LivioScherrer/MinTurtle/hardware/docs/pcb-bottom.png

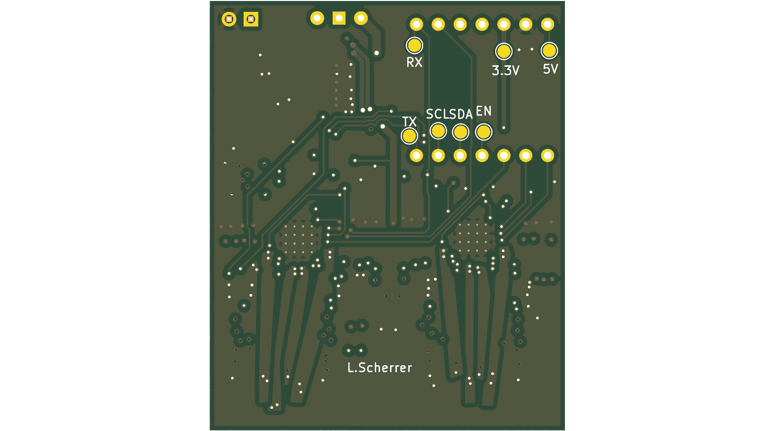
hardware/docs/pcb-bottom.png
