LivioScherrer/MinTurtle/hardware/docs/pcb-top.png

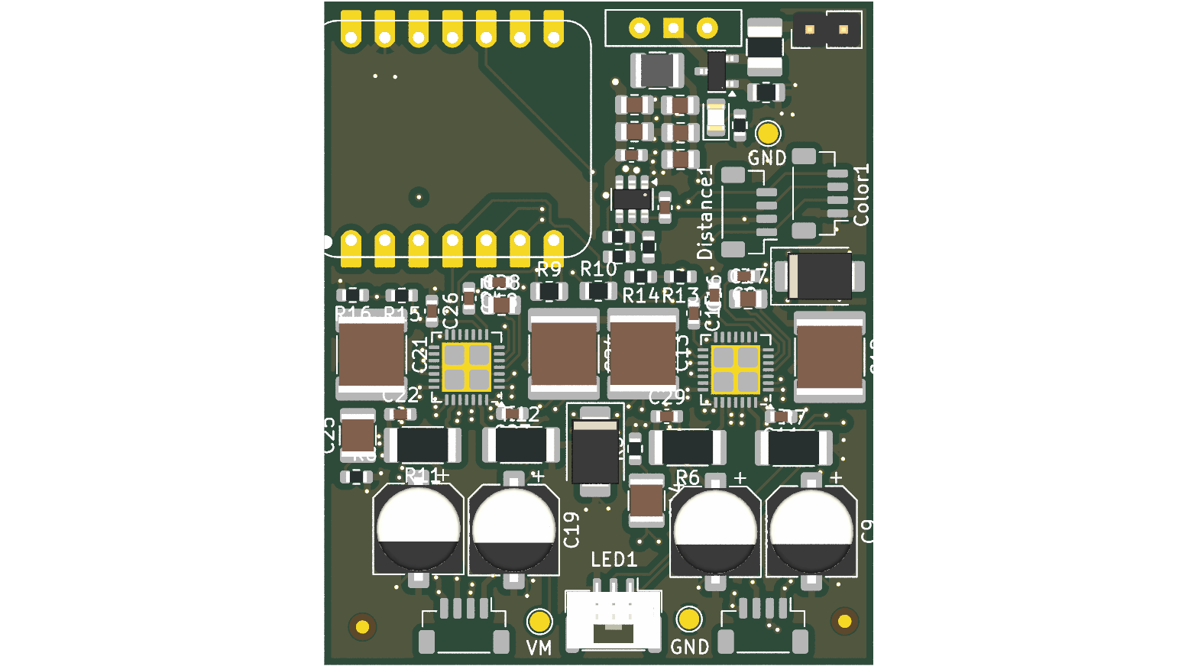
hardware/docs/pcb-top.png
