LivioScherrer/MinTurtle/hardware/3d-models/PCB_Halter.step

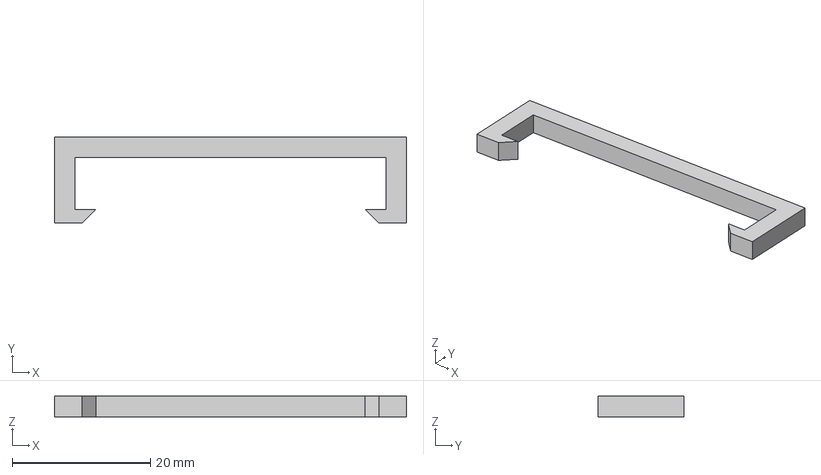
[picture p3: CAD file, 2026-10-19]
hardware/3d-models/PCB_Halter.step
51.0 x 12.5 x 3.00 mm
