LivioScherrer/MinTurtle/hardware/3d-models/ErhöhungV2.step

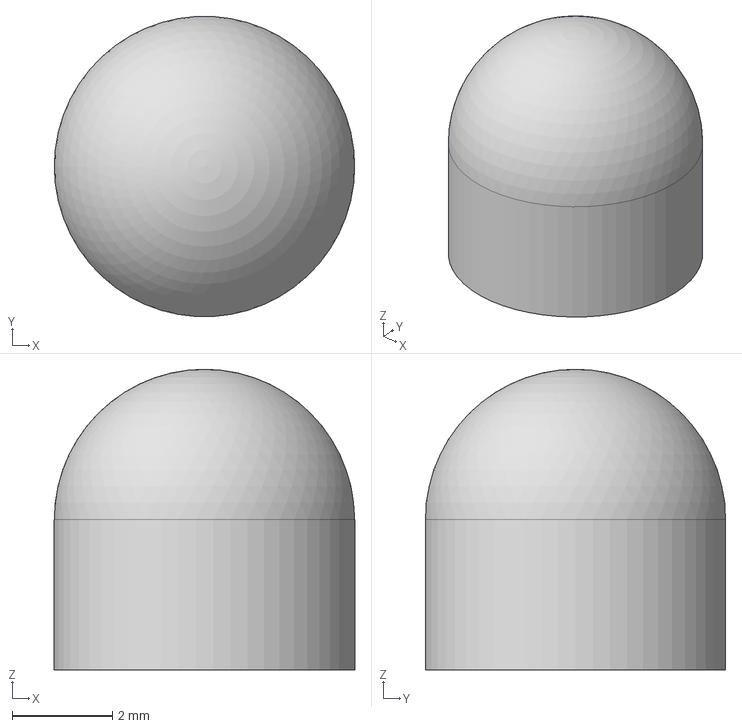
[picture p4: CAD file, 2026-10-19]
hardware/3d-models/ErhöhungV2.step
6.00 x 5.99 x 6.00 mm
