LivioScherrer/MinTurtle/hardware/3d-models/EduV2_Chassis.step

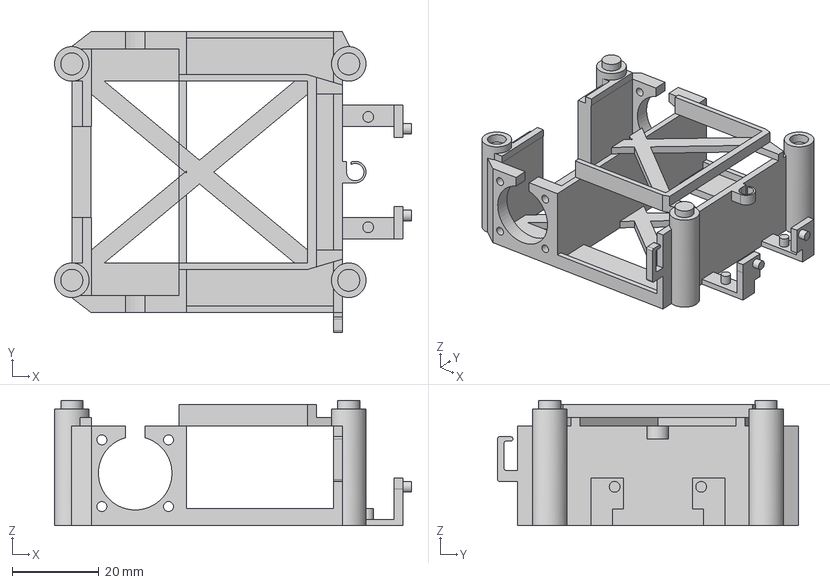
[picture p5: CAD file, 2026-10-19]
hardware/3d-models/EduV2_Chassis.step
82.5 x 69.6 x 29.0 mm
