LivioScherrer/MinTurtle/hardware/3d-models/RAD.step

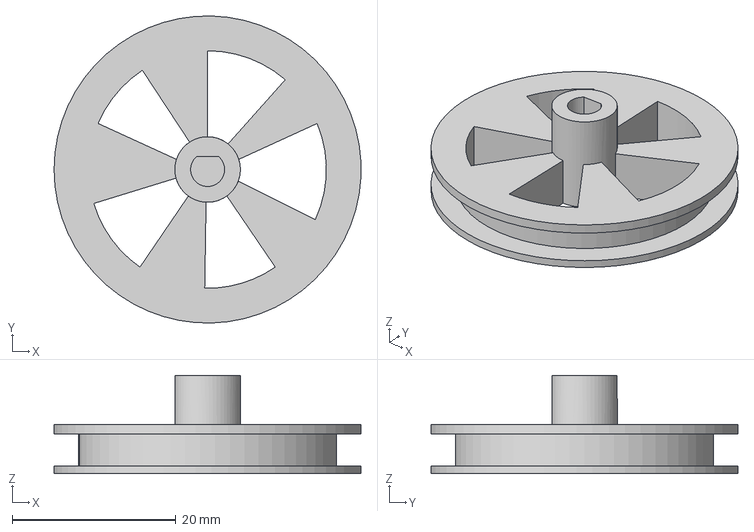
[picture p6: CAD file, 2026-10-19]
hardware/3d-models/RAD.step
37.5 x 37.5 x 12.0 mm
