LivioScherrer/MinTurtle/hardware/docs/schematic.pdf

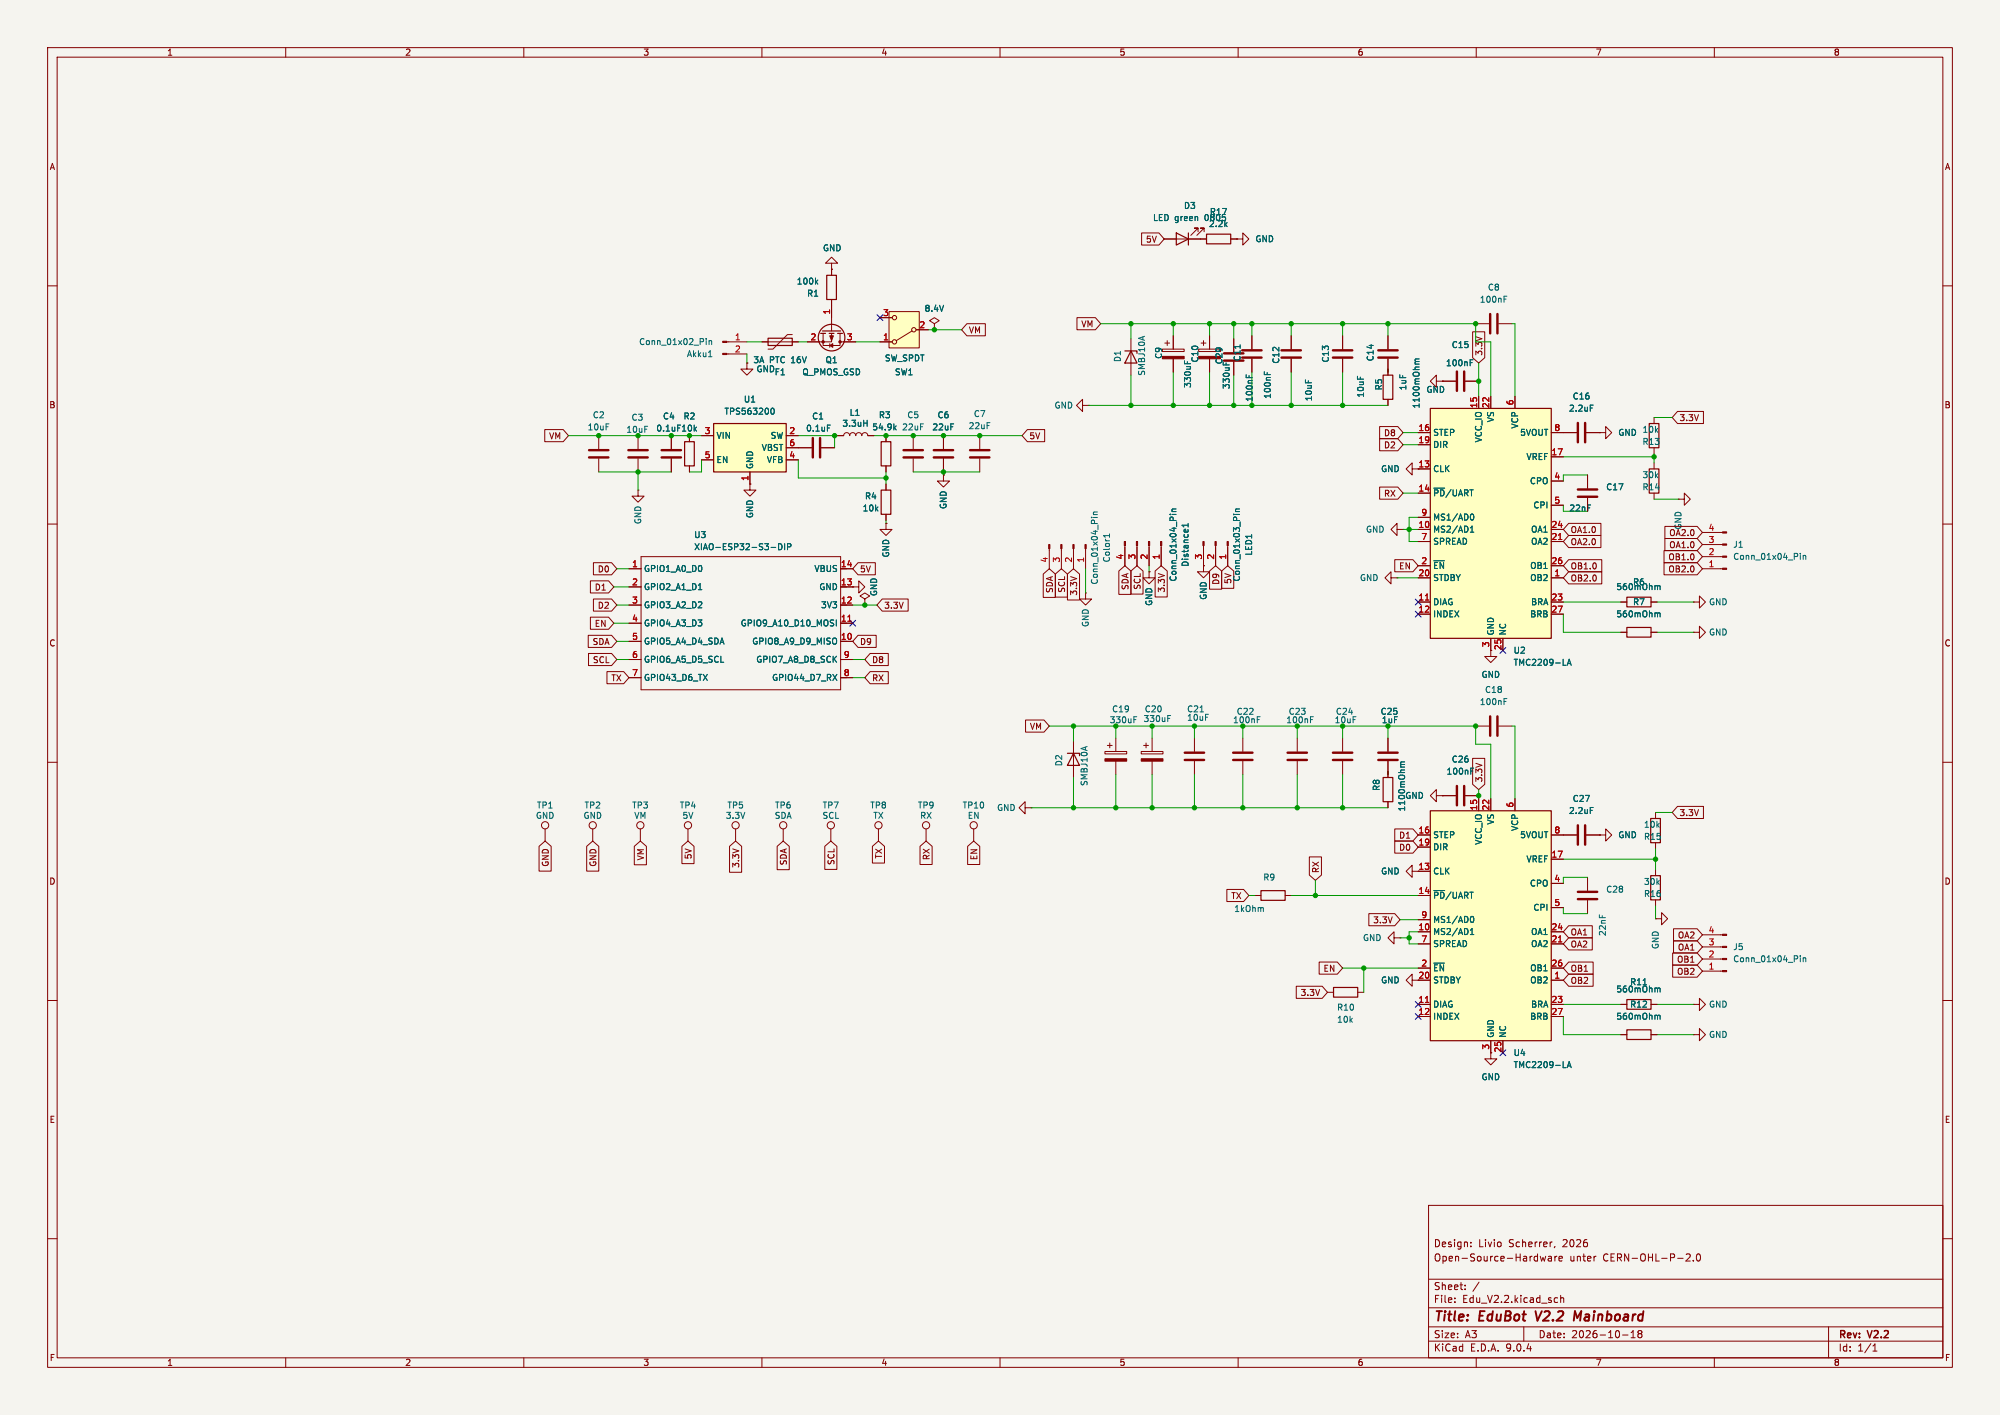
[picture p7: page 1]

560mOhm
STEP 16 DIR 19 CLK 13 ~{PD}/UART 14 MS1/AD0 9 MS2/AD1 10 SPREAD 7 ~{EN} 2 STDBY 20 DIAG 11

5VOUT 8 VREF 17 CPO 4 CPI 5 OA1 24 OA2 21 OB1 26 OB2 1 BRA 23 BRB 27 U4 TMC2209-LA

5VOUT 8 VREF 17 CPO 4 CPI 5 OA1 24 OA2 21 OB1 26 OB2 1 BRA 23 BRB 27 GND

Id: 1/1 Title: EduBot V2.2 Mainboard
