LivioScherrer/MinTurtle/hardware/Edu_V2.2.kicad_pcb

## KiCad design hardware/Edu_V2.2.kicad_pcb (2026-10-18)

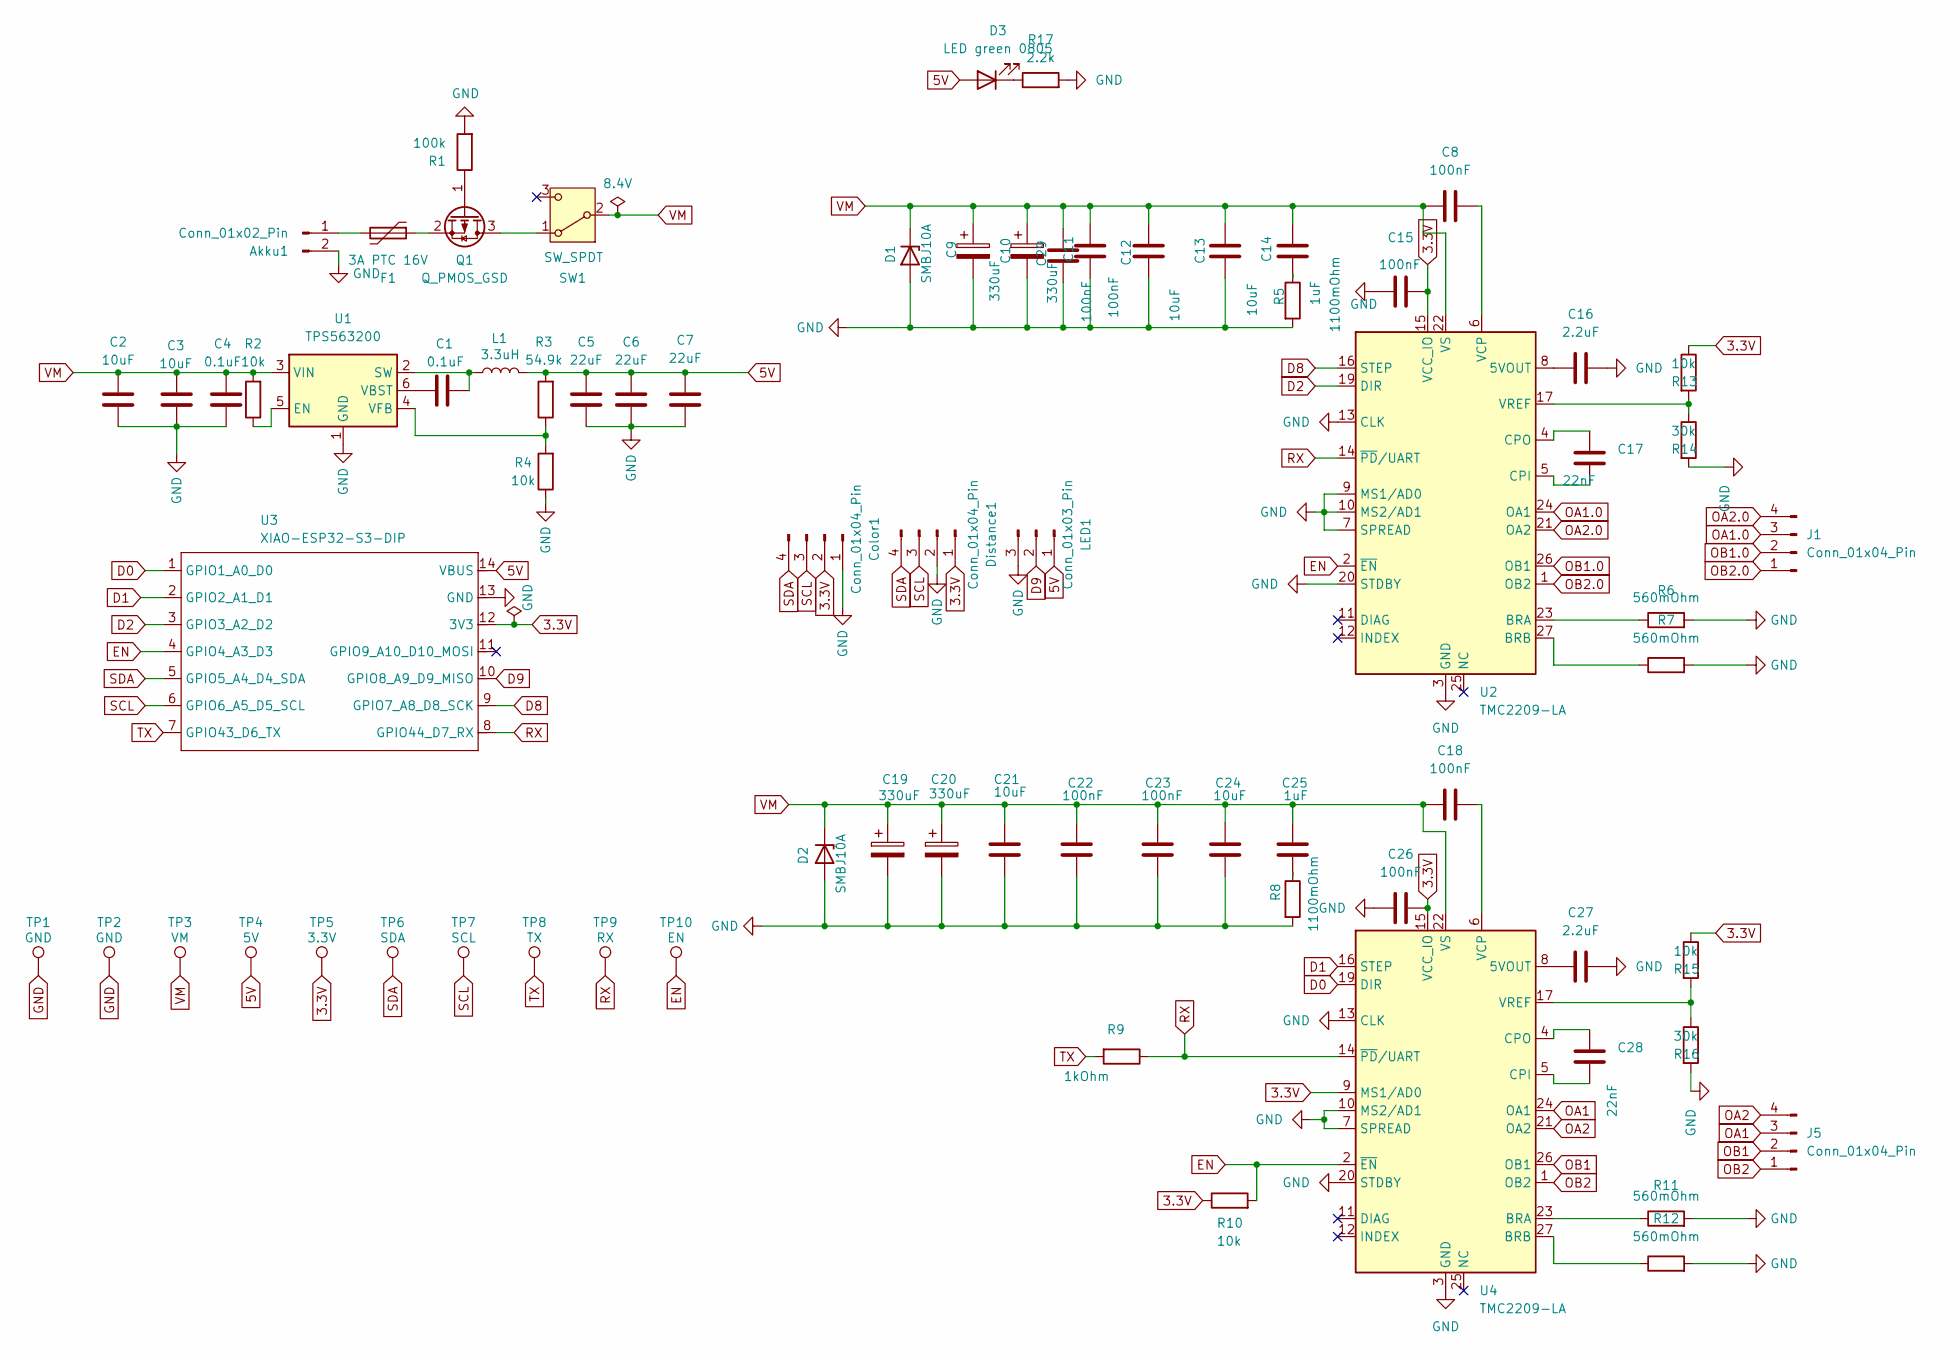
[picture p8: schematic Edu_V2.2.kicad_sch, EduBot V2.2 Mainboard]

Parts:
Akku1: Conn_01x02_Pin; PinHeader_1x02_P2.54mm_Vertical; MPN PZ254V-11-02P
C1, C4: 0.1uF; C_0603_1608Metric; MPN CC0603KRX7R9BB104; LCSC C14663
C2, C3: 10uF; C_0805_2012Metric; MPN CL21A106KAYNNNE; LCSC C15850
C5, C6, C7: 22uF; C_0805_2012Metric; MPN CL21A226MAQNNNE; LCSC C45783
C8, C11, C15, C18, C22, C23, C26, C29: 100nF; C_0603_1608Metric; MPN CC0603KRX7R9BB104; LCSC C14663
C9, C10, C19, C20: 330uF; CP_Elec_6.3x7.7; MPN GVM1E331M0607; LCSC C2980171
C12, C13, C21, C24: 10uF; C_2220_5750Metric; MPN FS55X106K500EGG; LCSC C153034
C14, C25: 1uF; C_1210_3225Metric; MPN CL32B105KBHNNNE; LCSC C40708
C16, C27: 2.2uF; C_0603_1608Metric; MPN CC0603KRX5R8BB225; LCSC C309478
C17, C28: 22nF; C_0805_2012Metric; MPN CL21B223KBANNNC; LCSC C1729
Color1: Conn_01x04_Pin; JST_SH_BM04B-SRSS-TB_1x04-1MP_P1.00mm_Vertical; MPN BM04B-SRSS-TB(LF)(SN); LCSC C160390
D1, D2: SMBJ10A; D_SMB; MPN SMBJ10A; LCSC C353406
D3: LED green 0805; LED_0805_2012Metric; MPN KT-0805G; LCSC C2297
Distance1: Conn_01x04_Pin; JST_SH_BM04B-SRSS-TB_1x04-1MP_P1.00mm_Vertical; MPN BM04B-SRSS-TB(LF)(SN); LCSC C160390
F1: 3A PTC 16V; Fuse_1210_3225Metric_Pad1.42x2.65mm_HandSolder; MPN 1210L300/16WR; LCSC C22379948
J1, J5: Conn_01x04_Pin; JST_SH_BM04B-SRSS-TB_1x04-1MP_P1.00mm_Vertical; MPN BM04B-SRSS-TB(LF)(SN); LCSC C160390
L1: 3.3uH; L_1210_3225Metric; MPN DFE322512F-3R3M=P2; LCSC C3221010
LED1: Conn_01x03_Pin; JST_GH_BM03B-GHS-TBT_1x03-1MP_P1.25mm_Vertical; MPN BM03B-GHS-TBT(LF)(SN); LCSC C161691
Q1: Q_PMOS_GSD; SOT-23; MPN AO3401A; LCSC C15127
R1: 100k; R_0805_2012Metric; MPN 0805W8F1003T5E; LCSC C149504
R2, R4, R13, R15: 10k; R_0603_1608Metric; MPN 0603WAF1002T5E; LCSC C25804
R3: 54.9k; R_0603_1608Metric; MPN 0603WAF5492T5E; LCSC C23077
R5, R8: 1100mOhm; R_0603_1608Metric; MPN RCT031R1JLF; LCSC C177315
R6, R7, R11, R12: 560mOhm; R_2010_5025Metric; MPN CR2010FR560E04R; LCSC C165409
R9: 1kOhm; R_0805_2012Metric; MPN 0805W8F1001T5E; LCSC C17513
R10: 10k; R_0805_2012Metric; MPN 0805W8F1002T5E; LCSC C17414
R14, R16: 30k; R_0603_1608Metric; MPN 0603WAF3002T5E; LCSC C22984
R17: 2.2k; R_0603_1608Metric; MPN 0603WAF2201T5E; LCSC C4190
SW1: SW_SPDT; SW_Slide-03_Wuerth-WS-SLTV_10x2.5x6.4_P2.54mm
TP1, TP2: GND; TestPoint_Pad_D1.5mm
TP3: VM; TestPoint_Pad_D1.5mm
TP4: 5V; TestPoint_Pad_D1.5mm
TP5: 3.3V; TestPoint_Pad_D1.5mm
TP6: SDA; TestPoint_Pad_D1.5mm
TP7: SCL; TestPoint_Pad_D1.5mm
TP8: TX; TestPoint_Pad_D1.5mm
TP9: RX; TestPoint_Pad_D1.5mm
TP10: EN; TestPoint_Pad_D1.5mm
U1: TPS563200; SOT-23-6; MPN TPS563200DDCR; LCSC C97253
U2, U4: TMC2209-LA; VQFN-28-1EP_5x5mm_P0.5mm_EP3.7x3.7mm_ThermalVias; MPN TMC2209-LA-T; LCSC C2150710
U3: XIAO-ESP32-S3-DIP

Connections:
3.3V: C15.2, C26.2, Color1.2, Distance1.1, R10.1, R13.1, R15.1, TP5.1, U2.15 (VCC_IO), U3.12 (3V3), U4.9 (MS1/AD0), U4.15 (VCC_IO)
5V: C5.2, C6.2, C7.2, D3.2 (A), L1.2, LED1.1, R3.2, TP4.1, U3.14 (VBUS)
D0: U3.1 (GPIO1_A0_D0), U4.19 (DIR)
D1: U3.2 (GPIO2_A1_D1), U4.16 (STEP)
D2: U2.19 (DIR), U3.3 (GPIO3_A2_D2)
D8: U2.16 (STEP), U3.9 (GPIO7_A8_D8_SCK)
D9: LED1.2, U3.10 (GPIO8_A9_D9_MISO)
EN: R10.2, TP10.1, U2.2 (~EN), U3.4 (GPIO4_A3_D3), U4.2 (~EN)
GND: Akku1.2 (GND), C2.1, C3.1, C4.1, C5.1, C6.1, C7.1, C9.2, C10.2, C11.1, C12.1, C13.1, C15.1, C16.1, C19.2, C20.2, C21.1, C22.1, C23.1, C24.1, C26.1, C27.1, C29.1, Color1.1, D1.2 (A), D2.2 (A), Distance1.2, LED1.3, R1.2, R4.1, R5.2, R6.2, R7.2, R8.2, R11.2, R12.2, R14.2, R16.2, R17.2, TP1.1, TP2.1, U1.1 (GND), U2.3 (GND), U2.7 (SPREAD), U2.9 (MS1/AD0), U2.10 (MS2/AD1), U2.13 (CLK), U2.18 (GND), U2.20 (STDBY), U2.29 (GND), U3.13 (GND), U4.3 (GND), U4.7 (SPREAD), U4.10 (MS2/AD1), U4.13 (CLK), U4.18 (GND), U4.20 (STDBY), U4.29 (GND)
unnamed: Akku1.1 (VCC), F1.2
unnamed: C14.1, R5.1
unnamed: C25.1, R8.1
unnamed: D3.1 (K), R17.1
unnamed: Q1.3 (D), SW1.1 (A)
unnamed: Q1.1 (G), R1.1
unnamed: F1.1, Q1.2 (S)
unnamed: R2.1, U1.5 (EN)
unnamed: C1.2, L1.1, U1.2 (SW)
unnamed: C1.1, U1.6 (VBST)
unnamed: R3.1, R4.2, U1.4 (VFB)
unnamed: C16.2, U2.8 (5VOUT)
unnamed: R6.1, U2.23 (BRA)
unnamed: R7.1, U2.27 (BRB)
unnamed: C17.1, U2.5 (CPI)
unnamed: C17.2, U2.4 (CPO)
unnamed: C8.2, U2.6 (VCP)
unnamed: R13.2, R14.1, U2.17 (VREF)
unnamed: C27.2, U4.8 (5VOUT)
unnamed: R11.1, U4.23 (BRA)
unnamed: R12.1, U4.27 (BRB)
unnamed: C28.1, U4.5 (CPI)
unnamed: C28.2, U4.4 (CPO)
unnamed: C18.2, U4.6 (VCP)
unnamed: R15.2, R16.1, U4.17 (VREF)
OA1: J5.3, U4.24 (OA1)
OA1.0: J1.3, U2.24 (OA1)
OA2: J5.4, U4.21 (OA2)
OA2.0: J1.4, U2.21 (OA2)
OB1: J5.2, U4.26 (OB1)
OB1.0: J1.2, U2.26 (OB1)
OB2: J5.1, U4.1 (OB2)
OB2.0: J1.1, U2.1 (OB2)
RX: R9.1, TP9.1, U2.14 (~PD/UART), U3.8 (GPIO44_D7_RX), U4.14 (~PD/UART)
SCL: Color1.3, Distance1.3, TP7.1, U3.6 (GPIO6_A5_D5_SCL)
SDA: Color1.4, Distance1.4, TP6.1, U3.5 (GPIO5_A4_D4_SDA)
TX: R9.2, TP8.1, U3.7 (GPIO43_D6_TX)
VM: C2.2, C3.2, C4.2, C8.1, C9.1, C10.1, C11.2, C12.2, C13.2, C14.2, C18.1, C19.1, C20.1, C21.2, C22.2, C23.2, C24.2, C25.2, C29.2, D1.1 (K), D2.1 (K), R2.2, SW1.2 (B), TP3.1, U1.3 (VIN), U2.22 (VS), U2.28 (VS), U4.22 (VS), U4.28 (VS)

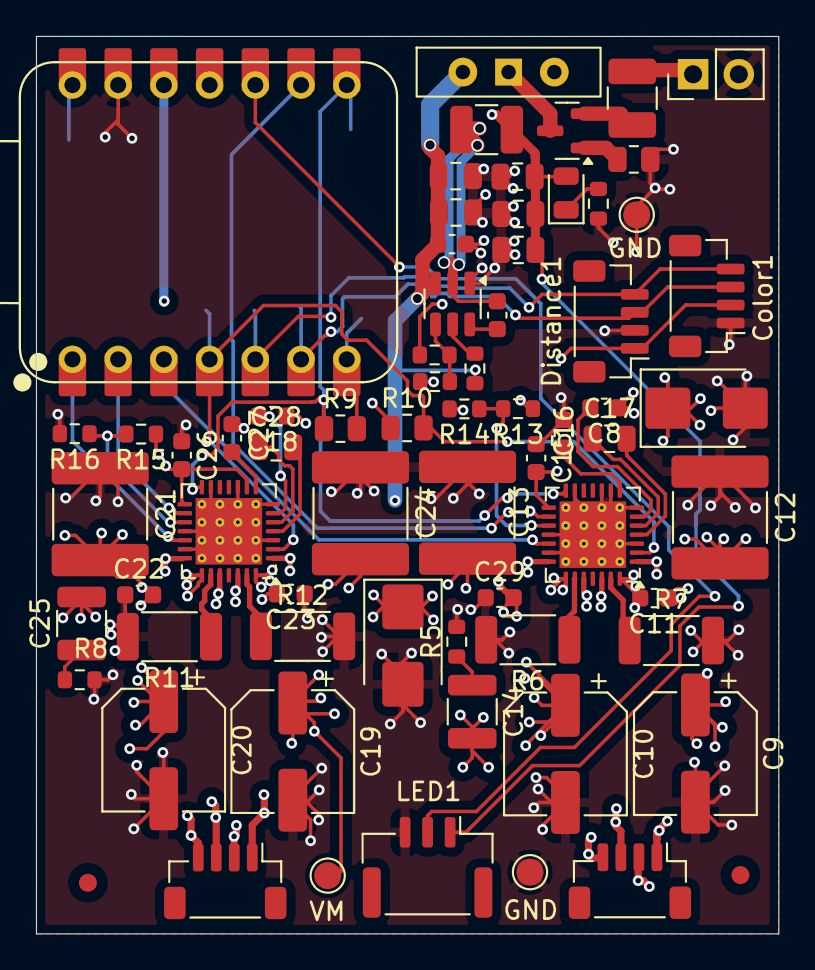
[picture p9: board Edu_V2.2.kicad_pcb from above]

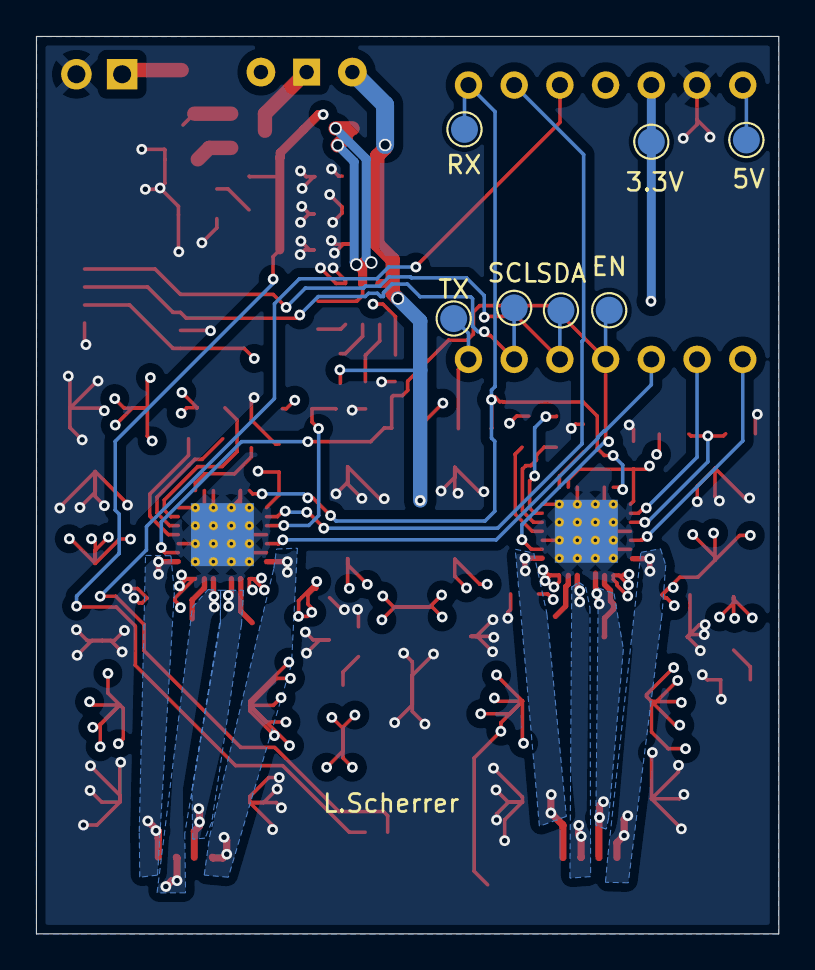
[picture p10: board Edu_V2.2.kicad_pcb from below]

Board: 4 copper layers, 41.2 x 49.9 mm, 75 parts (7 on the bottom side), 47 nets.

Other parts of the board:
FID1, FID2: Fiducial_1mm_Mask2mm
