LivioScherrer/MinTurtle/software/src/ColorSensor.h

#pragma once

#include <Arduino.h>
#include <Wire.h>
#include <Adafruit_TCS34725.h>

#define SDA_PIN 5
#define SCL_PIN 6

constexpr uint16_t COLOR_LOW  = 40;
constexpr uint16_t COLOR_HIGH = 200;
constexpr float    RATIO_RED  = 1.35f;
constexpr float    RATIO_GB   = 1.25f;

extern Adafruit_TCS34725 tcs;
extern volatile int sensorR, sensorG, sensorB;
extern volatile uint16_t rawSensorR, rawSensorG, rawSensorB, rawSensorC;
extern volatile char sensorName[16];
extern SemaphoreHandle_t colorSem;
extern volatile bool colorSensorOk;

void colorSetup();
void colorSensorTask(void* parameter);
bool resetI2CBus();
void getCurrentColorName(char* out, size_t outLen);
int calibrateColor(uint16_t raw, uint16_t blackVal, uint16_t whiteVal);
const char* detectColorName(int r, int g, int b);
