LivioScherrer/MinTurtle/software/src/I2CBus.cpp

#include "I2CBus.h"

static SemaphoreHandle_t s_bus = nullptr;

void i2cBusInit() {
  if (s_bus) return;
  s_bus = xSemaphoreCreateMutex();
  if (!s_bus) Serial.println("[I2C] FATAL: Bus-Mutex nicht anlegbar");
}

bool i2cBusLock(uint32_t timeoutMs) {
  if (!s_bus) return false;
  return xSemaphoreTake(s_bus, pdMS_TO_TICKS(timeoutMs)) == pdTRUE;
}

void i2cBusUnlock() {
  if (s_bus) xSemaphoreGive(s_bus);
}
