LivioScherrer/MinTurtle/(commit log)

2026-10-10 Deploy: nur HTML (WebUI) - Stand Arbeitsstand 2026-10-10 (12 neue Spiel-Modi, Duell, Symbolik, Button-Fixes)
2026-10-17 MinTurtle: Roboter-Code, Weboberfläche und Build-Dateien
    Open-Source-Stand, komplett ohne Kommentare:
    - src/: ESP32-Firmware (PlatformIO, Arduino)
    - Edu_V2.html + data/: Weboberfläche und Dateisystem-Inhalt (index.html.gz, Schriften)
    - platformio.ini + patch_vl53l0x.py: Build-Konfiguration
    Die vorhandene index.html bleibt unverändert.
2026-10-17 Linienfolger entfernt; Weboberflaeche als eigenstaendige index.html
    - Linienfolger komplett entfernt: Firmware (LineFollower, LINE:-Befehle, LED-Muster), samt Kachel, Ansicht und Hilfetexten der Oberflaeche.
    - Webseite heisst jetzt index.html und bringt Schriften und UX-Skripte eingebettet mit; sie laeuft damit auch einzeln gehostet (z. B. Cloudflare).
    - data/index.html.gz neu gebaut (kleiner; Roboter-Ablauf unveraendert).
2026-10-17 Tempo bis 200 mm/s einstellbar; StealthChop/SpreadCycle umschaltbar (FIX-TEST entfernt)
2026-10-18 Firmware und WebUI nach software/ verschoben
2026-10-18 Hardware: EduBot V2.2 Mainboard (KiCad-Projekt, Doku, CERN-OHL-P-2.0-Lizenz)
2026-10-19 WebUI: iOS-Darstellung und Slalom-Layout aktualisiert
2026-10-19 WebUI und Firmware: Spielewertungen, LEDs und Slalom-Zeitfahrt
