LivioScherrer/MinTurtle/(notices)

Notices in the files:
hardware/Edu_V2.2.kicad_sch:
Open-Source-Hardware unter CERN-OHL-P-2.0
